adafruit/Adafruit-1.69in-280x240-Round-Rectangle-TFT-PCB/Adafruit 1.69in 280x240 Round Rectangle TFT.brd

## EAGLE design Adafruit 1.69in 280x240 Round Rectangle TFT.brd (2021-09-02)

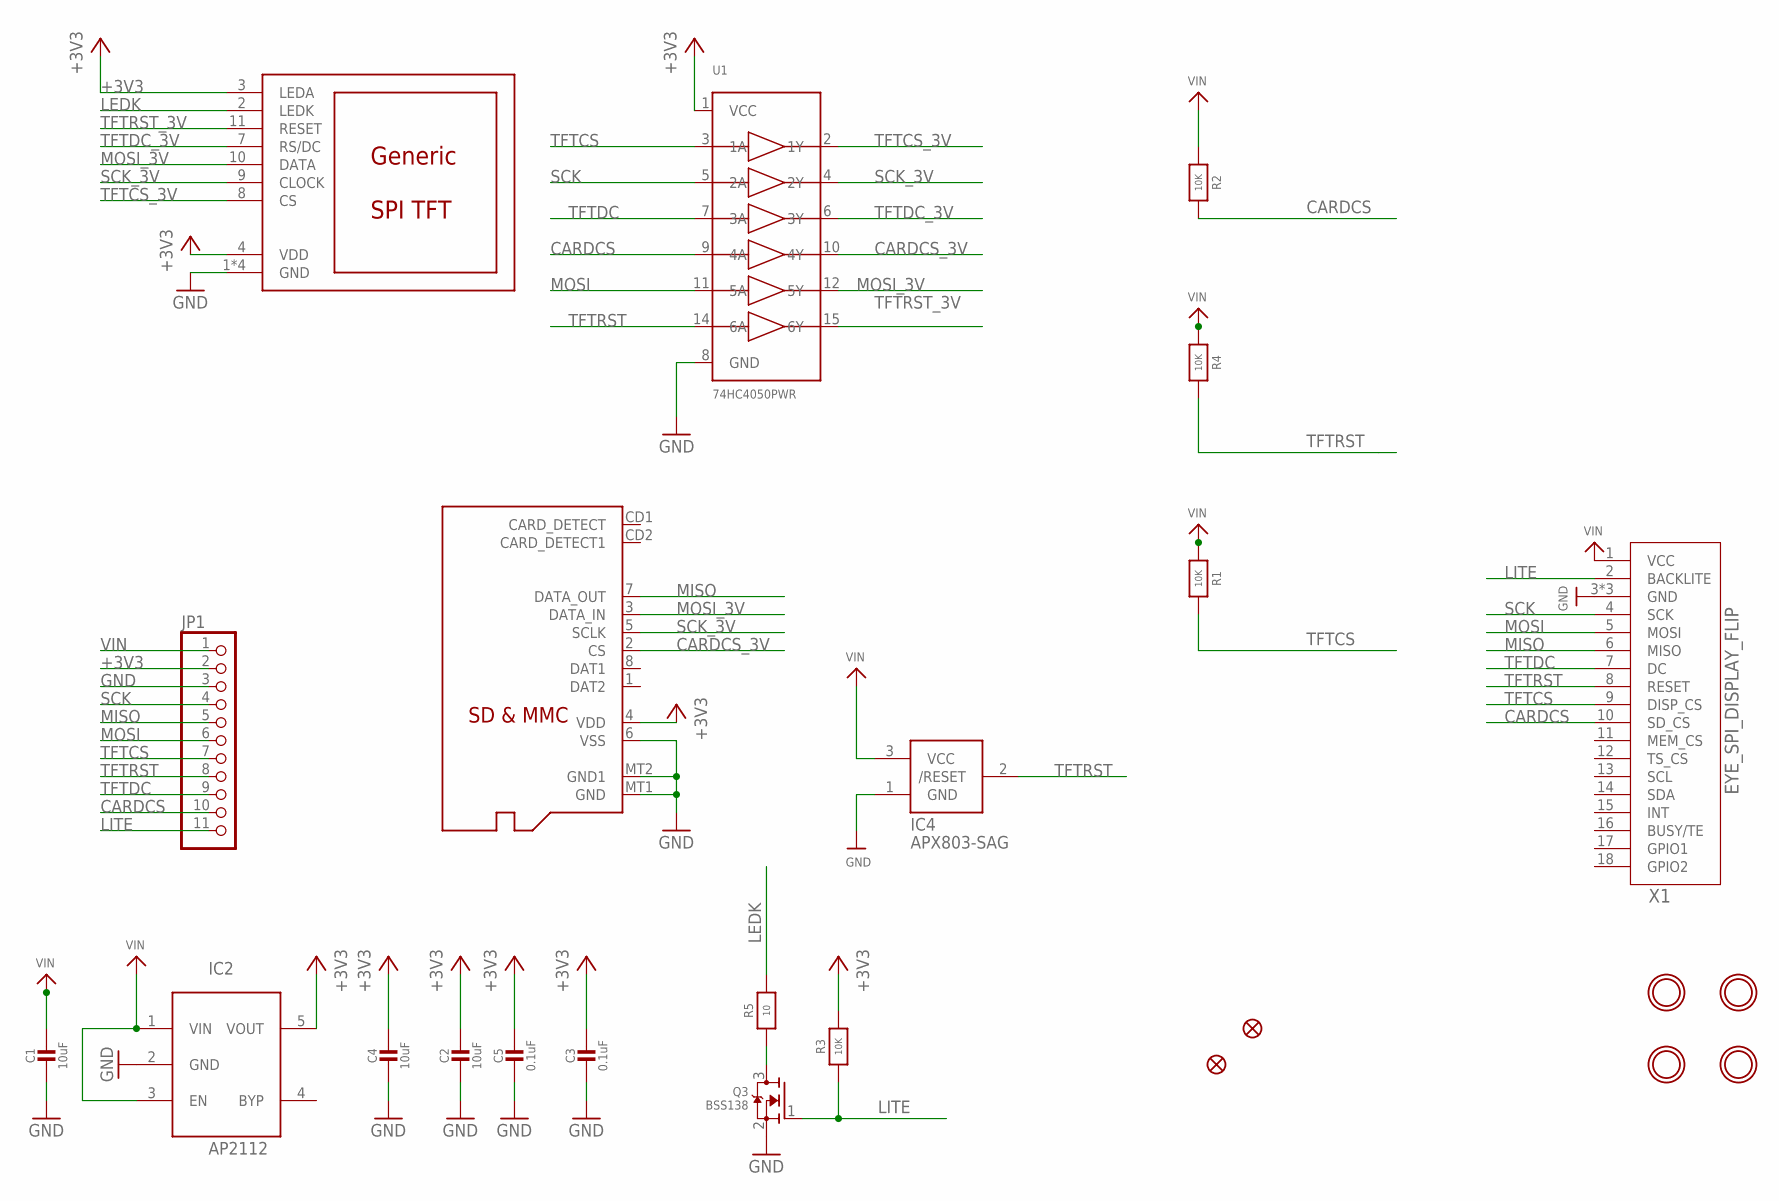
[picture p2: schematic Adafruit 1.69in 280x240 Round Rectangle TFT.sch]

Parts:
C1, C2, C4: 10uF; 0805-NO
C3, C5: 0.1uF; 0603-NO
DISP1: DISP_LCD_GENERIC_SPI_1.69_WRAPUNDER; TFT_1.69IN_240X280_12P
IC2: AP2112; SOT23-5L
IC4: APX803-SAG; SOT23
JP1: HEADER-1X1176MIL; 1X11_ROUND_76
Q2: MICROSD
Q3: BSS138; SOT23-WIDE
R1, R2, R3, R4: 10K; 0603-NO
R5: 10; 0603-NO
U1: 74HC4050PWR; TSSOP16
U$4, U$5: FIDUCIAL_1MM
U$7, U$8, U$9, U$10: MOUNTINGHOLE2.5; MOUNTINGHOLE_2.5_PLATED
X1: EYE_SPI_DISPLAY_FLIP; EYE_SPI_DISPLAY_BOTCONTACT

Connections:
+3V3: C2.1, C3.1, C4.1, C5.1, DISP1.3 (LEDA), DISP1.4 (VDD), IC2.5 (VOUT), JP1.2, Q2.4 (VDD), R3.2, U1.1 (VCC)
CARDCS: JP1.10, R2.1, U1.9 (4A), X1.10 (SD_CS)
CARDCS_3V: Q2.2 (CS), U1.10 (4Y)
GND: C1.2, C2.2, C3.2, C4.2, C5.2, DISP1.1 (GND), DISP1.5 (GND), DISP1.6 (GND), DISP1.12 (GND), IC2.2 (GND), IC4.1 (GND), JP1.3, Q2.6 (VSS), Q2.MT1 (GND), Q2.MT2 (GND1), Q3.2 (S), U1.8 (GND), X1.3 (GND), X1.SUPPORT1 (GND), X1.SUPPORT2 (GND)
LEDK: DISP1.2 (LEDK), R5.2
LITE: JP1.11, Q3.1 (G), R3.1, X1.2 (BACKLITE)
MISO: JP1.5, Q2.7 (DATA_OUT), X1.6 (MISO)
MOSI: JP1.6, U1.11 (5A), X1.5 (MOSI)
MOSI_3V: DISP1.10 (DATA), Q2.3 (DATA_IN), U1.12 (5Y)
unnamed: Q3.3 (D), R5.1
SCK: JP1.4, U1.5 (2A), X1.4 (SCK)
SCK_3V: DISP1.9 (CLOCK), Q2.5 (SCLK), U1.4 (2Y)
TFTCS: JP1.7, R1.1, U1.3 (1A), X1.9 (DISP_CS)
TFTCS_3V: DISP1.8 (CS), U1.2 (1Y)
TFTDC: JP1.9, U1.7 (3A), X1.7 (DC)
TFTDC_3V: DISP1.7 (RS/DC), U1.6 (3Y)
TFTRST: IC4.2 (/RESET), JP1.8, R4.1, U1.14 (6A), X1.8 (RESET)
TFTRST_3V: DISP1.11 (RESET), U1.15 (6Y)
VIN: C1.1, IC2.1 (VIN), IC2.3 (EN), IC4.3 (VCC), JP1.1, R1.2, R2.2, R4.2, X1.1 (VCC)

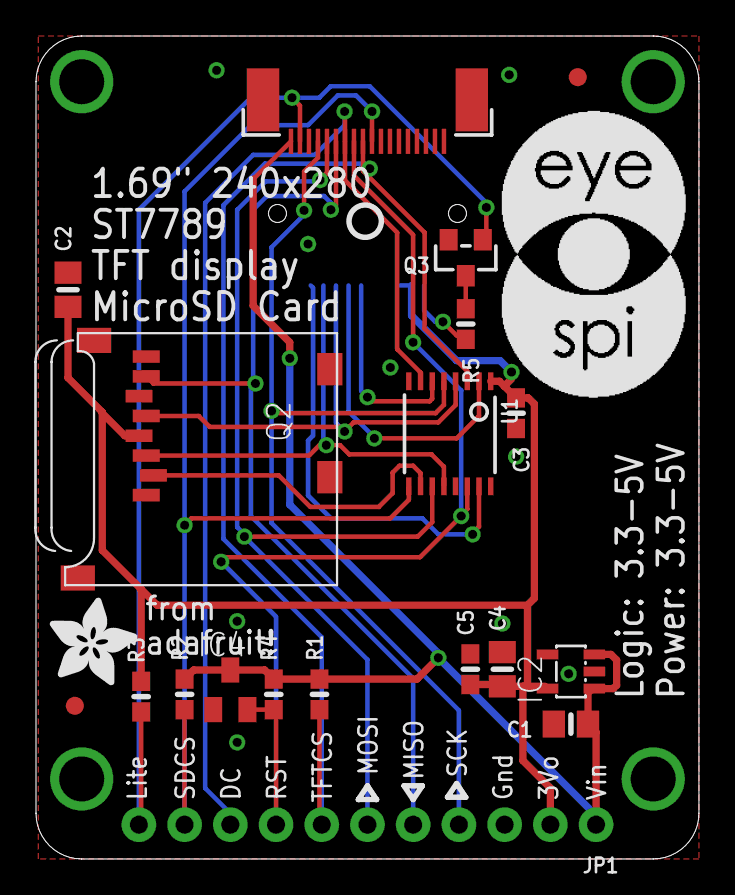
[picture p3: board Adafruit 1.69in 280x240 Round Rectangle TFT.brd from above]

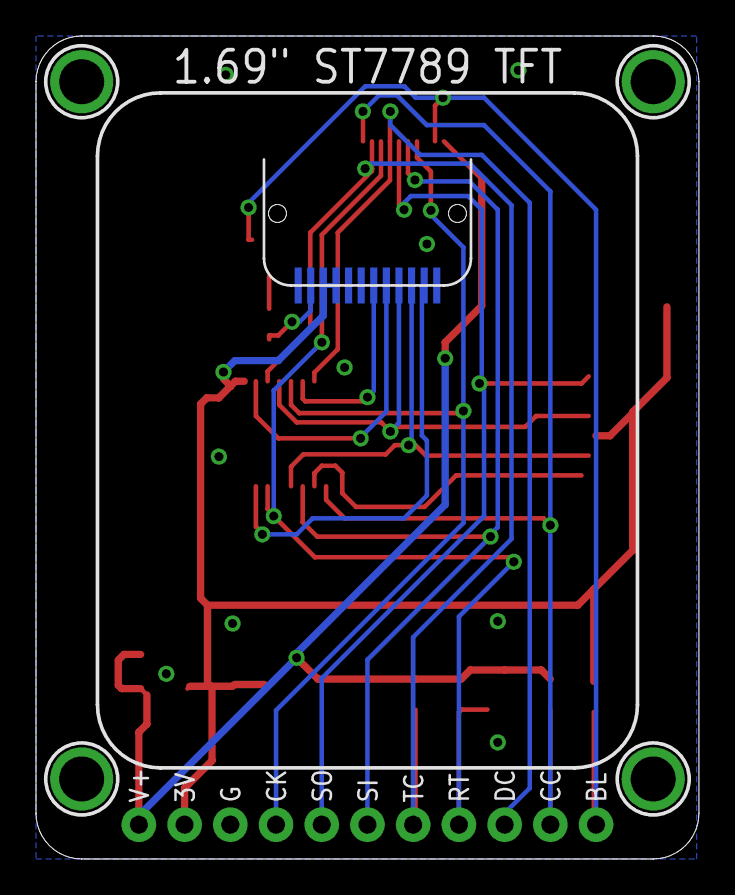
[picture p4: board Adafruit 1.69in 280x240 Round Rectangle TFT.brd from below]

Board: 2 copper layers, 36.8 x 45.7 mm, 27 parts (5 on the bottom side), 19 nets.

Other parts of the board:
U$1: ADAFRUIT_5MM
U$2: PCBFEAT-REV-040
U$19: EYESPI_LOGO
